jordigc2/AGV-Project/Code/interface/robotImg/robot.gif

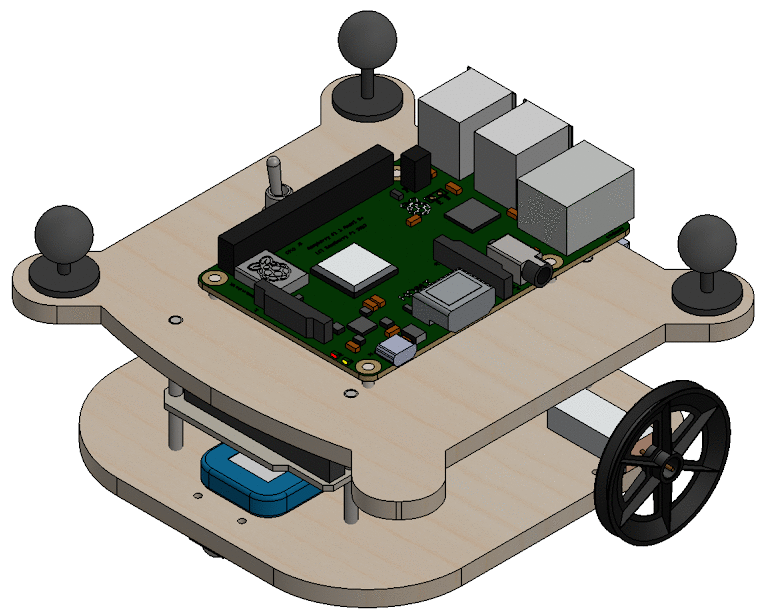
Code/interface/robotImg/robot.gif
