jordigc2/AGV-Project/Project-Schedule.pdf

Plan Duration | Actual Start | % Complete | Actual (beyond plan)
01/10/2018 | 08/10/2018 | 15/10/2018 | 22/10/2018 | 28/10/2018 | 05/11/2018 | 12/11/2018 | 19/11/2018 | 26/11/2018 | 03/12/2018 | 10/12/2018 | 17/12/2018
1 | 2 | 3 | 4 | 5 | 6 | 7 | 8 | 9 | 10 | 11 | 12
Hardware Diagram | Jordi | 1 | 1 | 1 | 100%
Gantt Diagram | Jordi | 1 | 1 | 1 | 1 | 100%
Class Diagram | Flemming | 1 | 1 | 1 | 100%
Communication Diagram | Rasmus | 1 | 1 | 1 | 100%
Simulation research | All | 1 | 4 | 1 | 0%

Control algorithms
research | All | 2 | 2 | 0%

Path planning
algorithms research | All | 2 | 2 | 0%

Task planning
algorithms research | All | 2 | 2 | 0%
Make report algorithms | All | 2 | 2 | 0%
Hardware Assembly | All | 4 | 1 | 0%

RPI3 - Arduino
Communication Test | All | 4 | 2 | 0%
Arduino - Motors Test | All | 4 | 2 | 0%
Arduino - Encoders Test | All | 4 | 2 | 0%
RPI3 - VICON Test | All | 4 | 2 | 0%
Testing Report | All | 4 | 2 | 0%
Mapping | All | 6 | 1 | 0%

Make robot do a route
(Routing) | All | 6 | 3 | 0%

Path planning
algorithms | All | 6 | 3 | 0%

Task planning
algorithms | All | 6 | 3 | 0%

Report of all the tests
done | All | 6 | 4 | 0%

Final prototype
integration | All | 10 | 1 | 0%
Last validation tests | All | 11 | 2 | 0%
Write final report | All | 10 | 3 | 0%

PERCENT
COMPLETE

ASSIGNED TO

# Project Planner: AGV-Project

% Complete (beyond plan)

ACTIVITY | PLAN START

PLAN
DURATION

ACTUAL
START

ACTUAL
DURATION
