jordigc2/AGV-Project/Code/interface/mapImg/map0_p1.gif

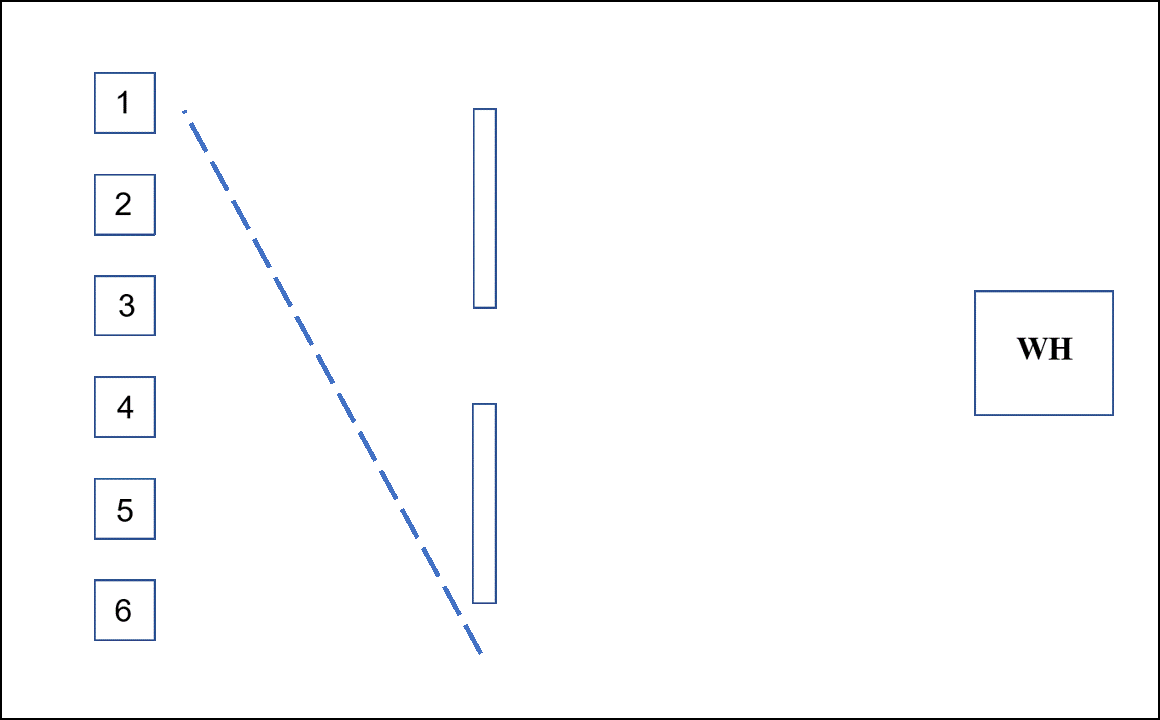
Code/interface/mapImg/map0_p1.gif
