jordigc2/AGV-Project/Code/interface/mapImg/map2_p5.gif

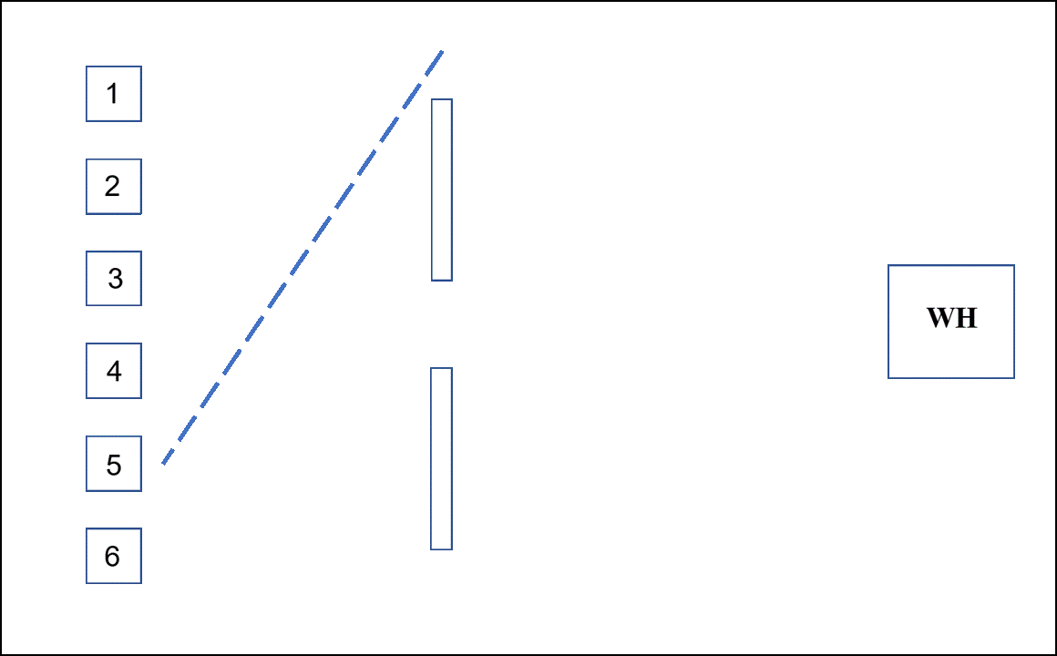
Code/interface/mapImg/map2_p5.gif
