jordigc2/AGV-Project/Code/interface/mapImg/mapW_0.gif

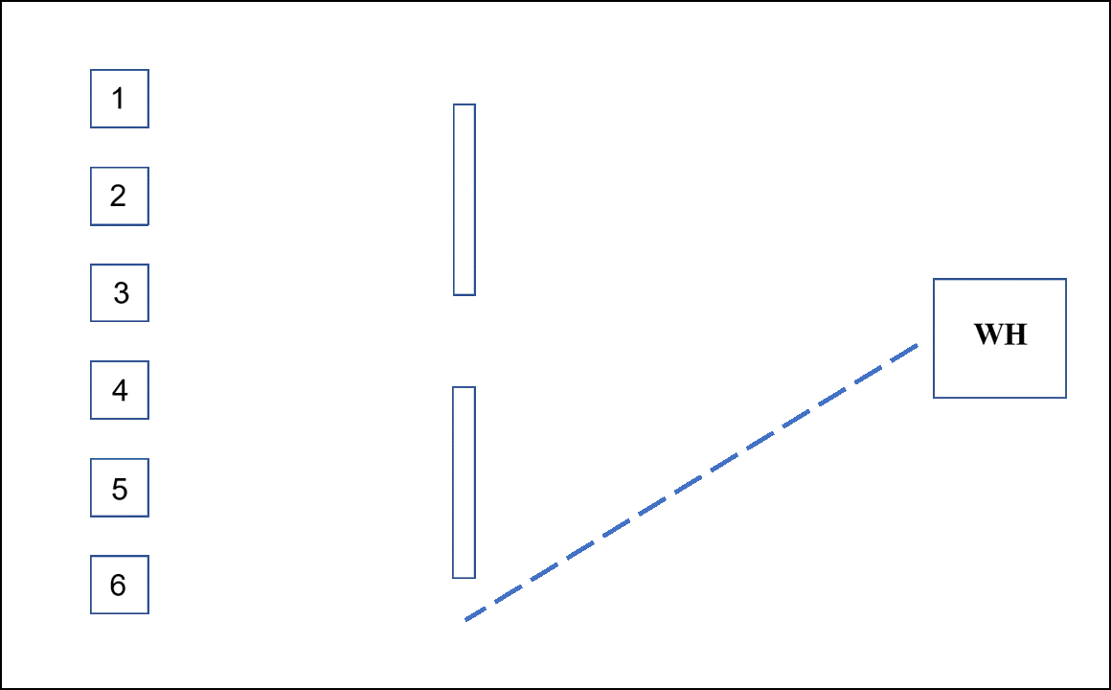
Code/interface/mapImg/mapW_0.gif
