jordigc2/AGV-Project/Code/interface/mapImg/mapW_2.gif

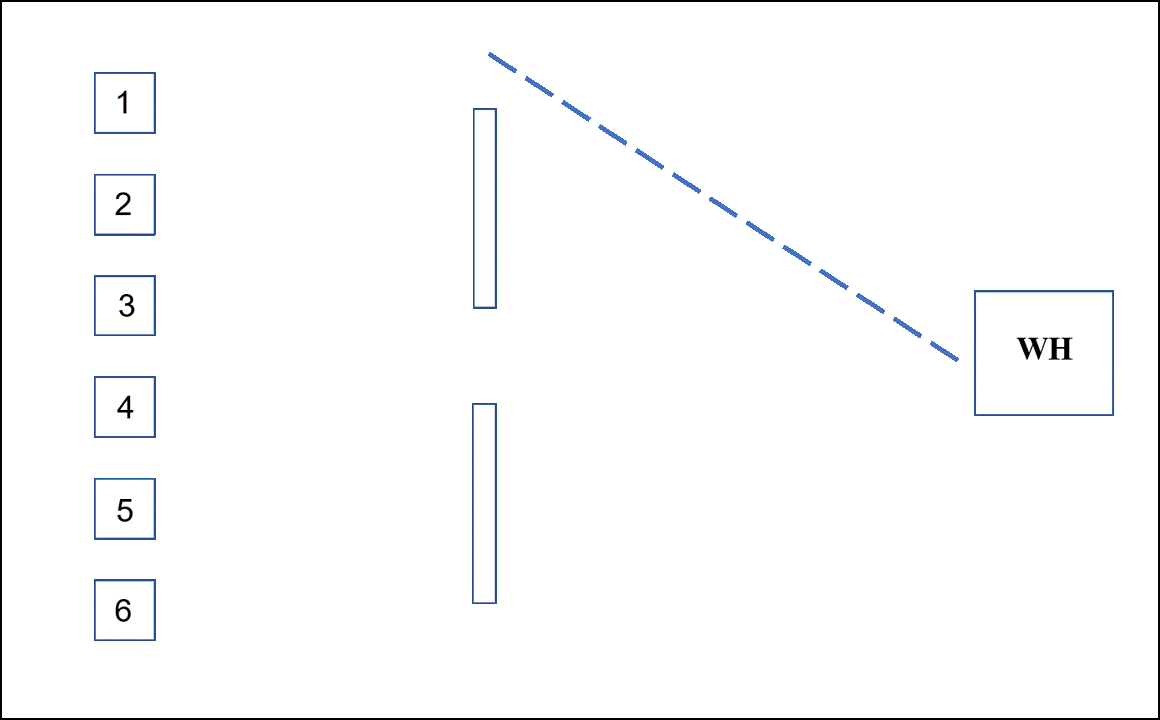
Code/interface/mapImg/mapW_2.gif
