jordigc2/AGV-Project/Documentation/Class diagram routing.gif

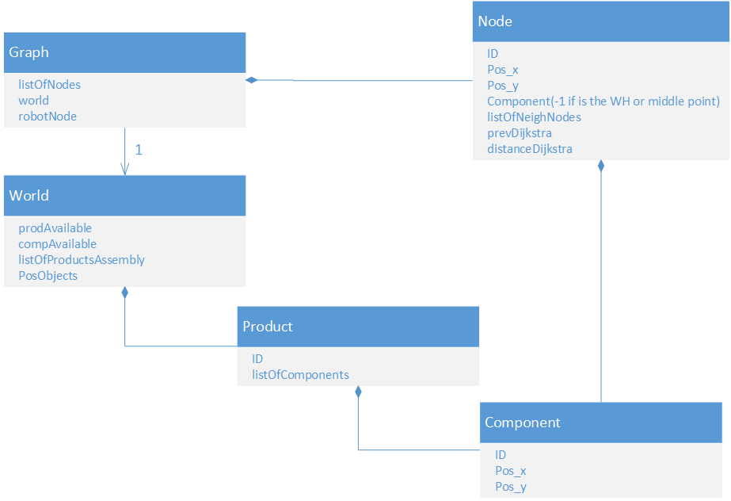
Documentation/Class diagram routing.gif
