jordigc2/AGV-Project/Documentation/Robot Diagram.png

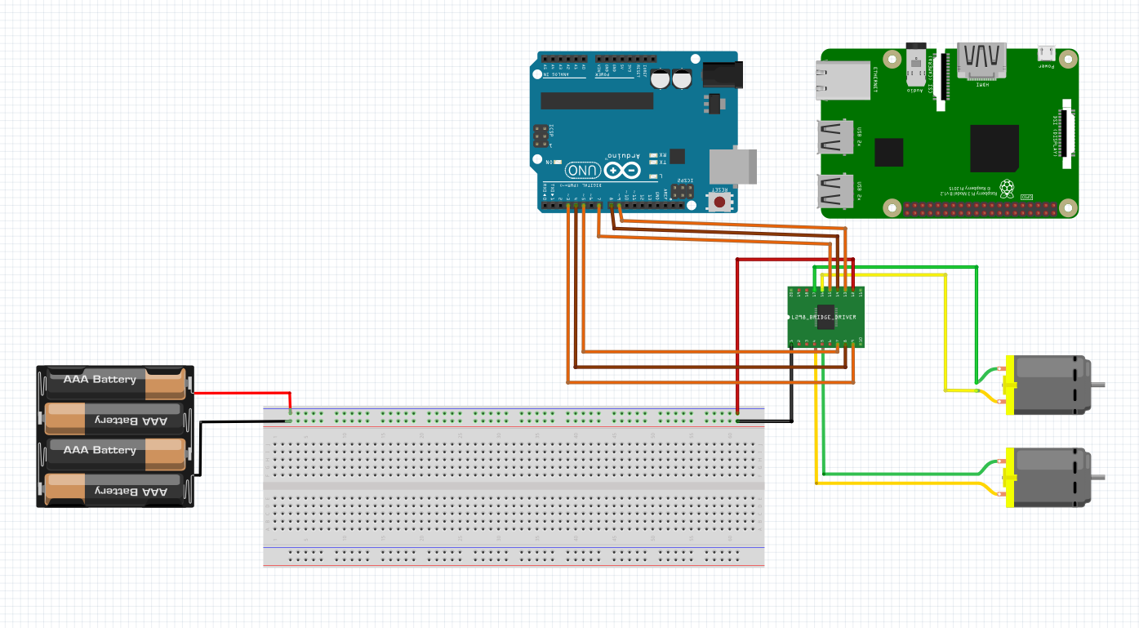
Documentation/Robot Diagram.png
