jordigc2/AGV-Project/Documentation/robot_trajectories_plot.png

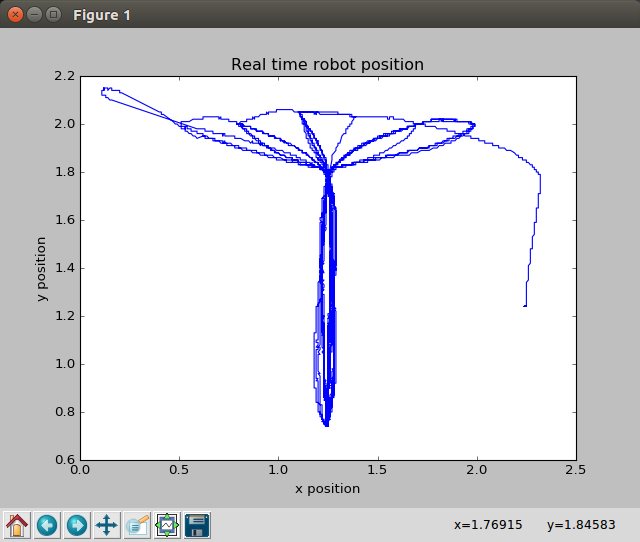
Documentation/robot_trajectories_plot.png
