jordigc2/AGV-Project/Documentation/ROS_diagram.png

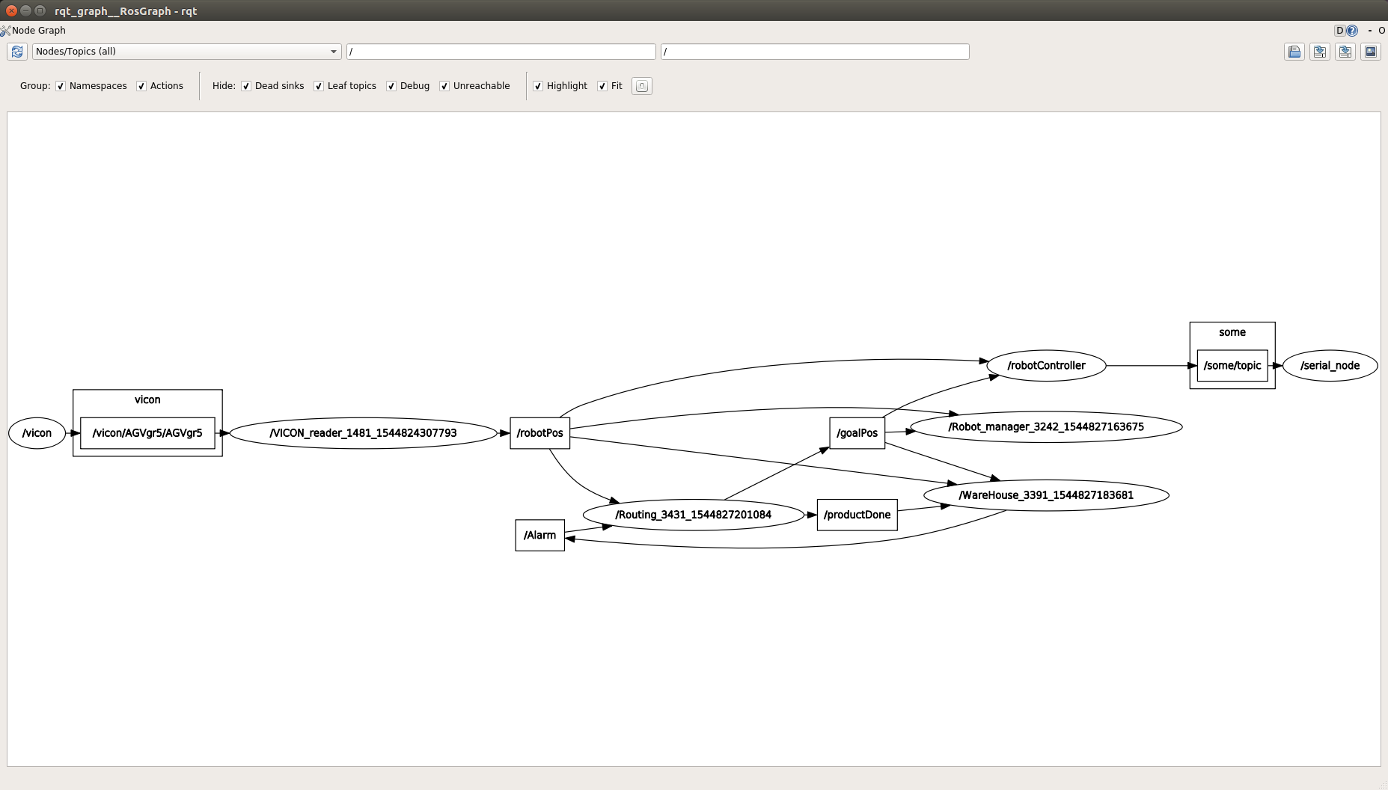
Documentation/ROS_diagram.png
