jordigc2/AGV-Project/Code/Tests/Scheduling algorithms comparison in terms of time.xlsx

TimeGreedy | TimeOpt | TimeGreedy | TimeOpt
24.605725 | 28.404561 | 24.605725 | 28.404561
24.419887 | 24.139128 | 49.025612 | 52.543689
34.736225 | 34.378548 | 83.761837 | 86.922237
37.577244 | 34.077294 | 121.339081 | 120.999531
22.306926 | 16.979106 | 143.646007 | 137.978637
26.339054 | 26.850461 | 169.985061 | 164.829098
27.840316 | 27.959454 | 197.825377 | 192.788552
21.567974 | 18.728132 | 219.393351 | 211.516684
30.030609 | 30.050805 | 249.42396 | 241.567489
26.930361 | 26.878712 | 276.354321 | 268.446201
26.42996 | 28.019552 | 302.784281 | 296.465753
35.999194 | 37.367494 | 338.783475 | 333.833247
22.117433 | 18.828098 | 360.900908 | 352.661345
27.020728 | 26.869861 | 387.921636 | 379.531206
26.431101 | 28.109583 | 414.352737 | 407.640789
35.836971 | 37.507285 | 450.189708 | 445.148074
22.115877 | 18.886746 | 472.305585 | 464.03482
30.310809 | 30.232037 | 502.616394 | 494.266857
26.939964 | 26.808859 | 529.556358 | 521.075716
26.490475 | 27.959552 | 556.046833 | 549.035268
35.98822 | 37.477591 | 592.035053 | 586.512859
22.158926 | 18.858453 | 614.193979 | 605.371312
24.159993 | 24.370523 | 638.353972 | 629.741835
36.068042 | 35.936239 | 674.422014 | 665.678074
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
