jordigc2/AGV-Project/AGV5/src/pyScripts/Tests/timeOpt.csv

Time
28.404561 | prod1
24.139128 | prod3
34.378548 | prod2
34.077294 | prod2
16.979106 | prod3
26.850461 | prod1
27.959454 | prod4
18.728132 | prod3
30.050805 | prod2
26.878712 | prod1
28.019552 | prod4
37.367494 | prod2
18.828098 | prod3
26.869861 | prod1
28.109583 | prod4
37.507285 | prod2
18.886746 | prod3
30.232037 | prod2
26.808859 | prod1
27.959552 | prod4
37.477591 | prod2
18.858453 | prod3
24.370523 | prod3
35.936239 | prod2
21.536218 | prod4
31.227576 | prod2
25.569492 | prod3
21.026482 | prod4
