jordigc2/AGV-Project/Code/Tests/flower.csv

X_raw | lim1 | lim2 | Y_raw
1.245757 | 1.203845 | 1.296155 | 1.695828
1.245734 | 1.203845 | 1.296155 | 1.691285
1.245438 | 1.203845 | 1.296155 | 1.686514
1.244496 | 1.203845 | 1.296155 | 1.680958
1.244286 | 1.203845 | 1.296155 | 1.676525
1.24364 | 1.203845 | 1.296155 | 1.671078
1.243974 | 1.203845 | 1.296155 | 1.66723
1.243099 | 1.203845 | 1.296155 | 1.661716
1.243442 | 1.203845 | 1.296155 | 1.657614
1.242932 | 1.203845 | 1.296155 | 1.652585
1.241987 | 1.203845 | 1.296155 | 1.646924
1.242759 | 1.203845 | 1.296155 | 1.643052
1.24225 | 1.203845 | 1.296155 | 1.638382
1.242643 | 1.203845 | 1.296155 | 1.63406
1.241993 | 1.203845 | 1.296155 | 1.628832
1.241773 | 1.203845 | 1.296155 | 1.623674
1.241972 | 1.203845 | 1.296155 | 1.619294
1.241422 | 1.203845 | 1.296155 | 1.613873
1.241151 | 1.203845 | 1.296155 | 1.608511
1.241544 | 1.203845 | 1.296155 | 1.604095
1.241196 | 1.203845 | 1.296155 | 1.599014
1.242019 | 1.203845 | 1.296155 | 1.594576
1.241276 | 1.203845 | 1.296155 | 1.58929
1.241376 | 1.203845 | 1.296155 | 1.584257
1.242117 | 1.203845 | 1.296155 | 1.579803
1.241184 | 1.203845 | 1.296155 | 1.574495
1.240539 | 1.203845 | 1.296155 | 1.568518
1.241893 | 1.203845 | 1.296155 | 1.564635
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
