jordigc2/AGV-Project/Code/Tests/timeGreedy.csv

Time
24.605725 | prod1
24.419887 | prod3
34.736225 | prod2
37.577244 | prod2
22.306926 | prod3
26.339054 | prod1
27.840316 | prod4
21.567974 | prod3
30.030609 | prod2
26.930361 | prod1
26.42996 | prod4
35.999194 | prod2
22.117433 | prod3
27.020728 | prod1
26.431101 | prod4
35.836971 | prod2
22.115877 | prod3
30.310809 | prod2
26.939964 | prod1
26.490475 | prod4
35.98822 | prod2
22.158926 | prod3
24.159993 | prod3
36.068042 | prod2
21.70411 | prod4
30.263802 | prod2
25.760428 | prod3
21.077259 | prod4
30.300891 | prod2
773.227613
