jordigc2/AGV-Project/(list of files, drawings)

Other design files:
Documentation/Robot Diagram.fzz
