jordigc2/AGV-Project/Code/examples/Motor_test/Motor_test.ino

//motor A connected between A01 and A02
//motor B connected between B01 and B02

int STBY = 10; //standby

//Motor A
int PWMA = 3; //Speed control
int AIN1 = 9; //Direction
int AIN2 = 8; //Direction

void setup(){
  pinMode(STBY, OUTPUT);
  
  pinMode(PWMA, OUTPUT);
  pinMode(AIN1, OUTPUT);
  pinMode(AIN2, OUTPUT);
}

void loop(){
  move(1, 255, 1); //motor 1, full speed, left
  
  delay(1000); //go for 1 second
  stop(); //stop
  delay(250); //hold for 250ms until move again
  
  move(1, 128, 0); //motor 1, half speed, right
  
  delay(1000);
  stop();
  delay(250);
}

void move(int motor, int speed, int direction){
  //Move specific motor at speed and direction
  //motor: 0 for B 1 for A
  //speed: 0 is off, and 255 is full speed
  //direction: 0 clockwise, 1 counter-clockwise
  
  digitalWrite(STBY, HIGH); //disable standby
  
  boolean inPin1 = LOW;
  boolean inPin2 = HIGH;
  
  if(direction == 1){
    inPin1 = HIGH;
    inPin2 = LOW;
  }
  
  if(motor == 1){
    digitalWrite(AIN1, inPin1);
    digitalWrite(AIN2, inPin2);
    analogWrite(PWMA, speed);
  }
}

void stop(){
  //enable standby
  digitalWrite(STBY, LOW);
}
