jordigc2/AGV-Project/(commit log)

2018-10-26 csv, new code
    csv with the diferents products, a ncoder test and some changes in the world file
    [productionPlan.csv]
2018-11-01 added world model and changed robot shape
    [agv_model.sdf]
2018-11-14 Routing "working"
    May need some revision in a future
    [productionPlan.csv]
2018-11-16 Waypoints added to simulation + planner python script
    [agv_model.sdf]
2018-12-18 Optimal path algorithm working, hopefully!
    [productionPlan3.csv, productionPlan30.csv]
2018-12-19 Last final tests!!!!
    [timeGreedy.csv, timeOpt.csv]
2019-01-24 security copy of the working AGV
    [productionPlan.csv, productionPlan30.csv, timeGreedy.csv, timeOpt.csv]
2019-01-25 Final report
    [productionPlan_contest.csv]
